willie68/w6502sbc/ideas.md

# Einige Ideen zum W6502SBC

## UART

- MAX3100 als Single UART per SPI
- Arduino Pro Micro als Single UART inkl. USB ansprechen per 6522 Bitbang SPI, oder evtl. eigenes Protokoll (Nibble Bus)

## Doppel bin2hex 7-seg 
https://www.instructables.com/Dual-BCD-to-Hex-7-Segment-Driver/
