willie68/w6502sbc/hardware/bestellen.md

# Bei Mouser

W65C02S  1x

https://www.mouser.de/ProductDetail/Western-Design-Center-WDC/W65C02S6TPG-14?qs=opBjA1TV903lvWo9AEKH5w%3D%3D

W65C22N2  2x

https://www.mouser.de/ProductDetail/Western-Design-Center-WDC/W65C22N6TPG-14?qs=opBjA1TV901DbgJ9rfcBoQ%3D%3D

CPLD ATF16V8B-15PU 5x

https://www.mouser.de/ProductDetail/?qs=2mdvTlUeTfCsdBIzx6v3gA%3D%3D

DS1813 2x

https://www.mouser.de/ProductDetail/Maxim-Integrated/DS1813-5%2bTR?qs=Jw2w9zrI6w81XtBxYQvCNA%3D%3D

DIl40 x10

DIL16 x10

DIL14 x10

DIL20 x10

DIL32 x10

# 

# Reichelt

Takt 1MHz und 8Mhz

https://www.reichelt.de/quarzoszillator-1-0-mhz-oszi-1-000000-p13673.html?&trstct=pos_1&nbc=1

https://www.reichelt.de/quarzoszillator-8-00-mhz-oszi-8-000000-p13723.html?&trstct=pos_2&nbc=1

Quarz 2x

https://www.reichelt.de/standardquarz-grundton-1-84-mhz-iqd-lfxtal003033-p245394.html?&trstct=pol_0&nbc=1

Kondensatoren 100nF 20x

https://www.reichelt.de/vielschicht-kerko-100nf-50v-125-c-c3x7r-100nb50-p206878.html?&trstct=pol_1&nbc=1

SST39SF010A 70ns, 128Kb Nor Flash

74HC138 5x

74HC688  5x

74HC00 5x

74HC85 4-Bit comparator 5x

# Ebay

R65C51 2x

Atf22V10C-15pu
