willie68/w6502sbc/images/20220719_144343.jpg

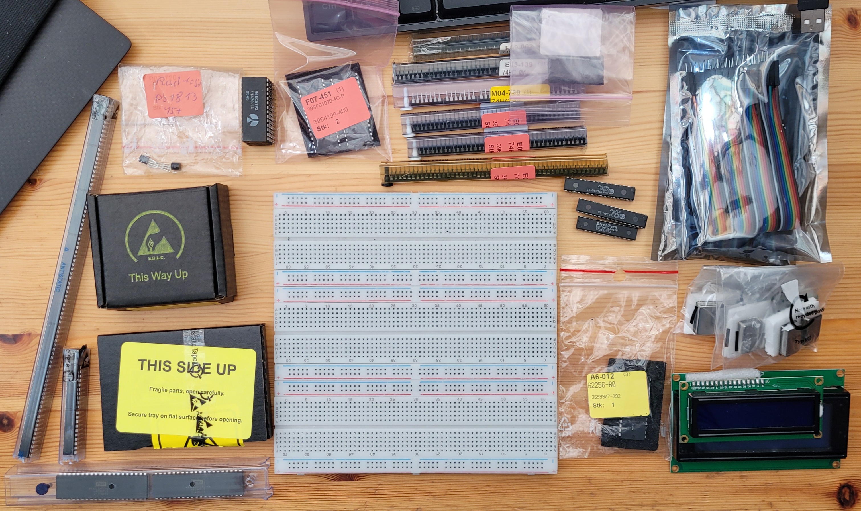
images/20220719_144343.jpg
