willie68/w6502sbc/images/NOP_Logic.jpg

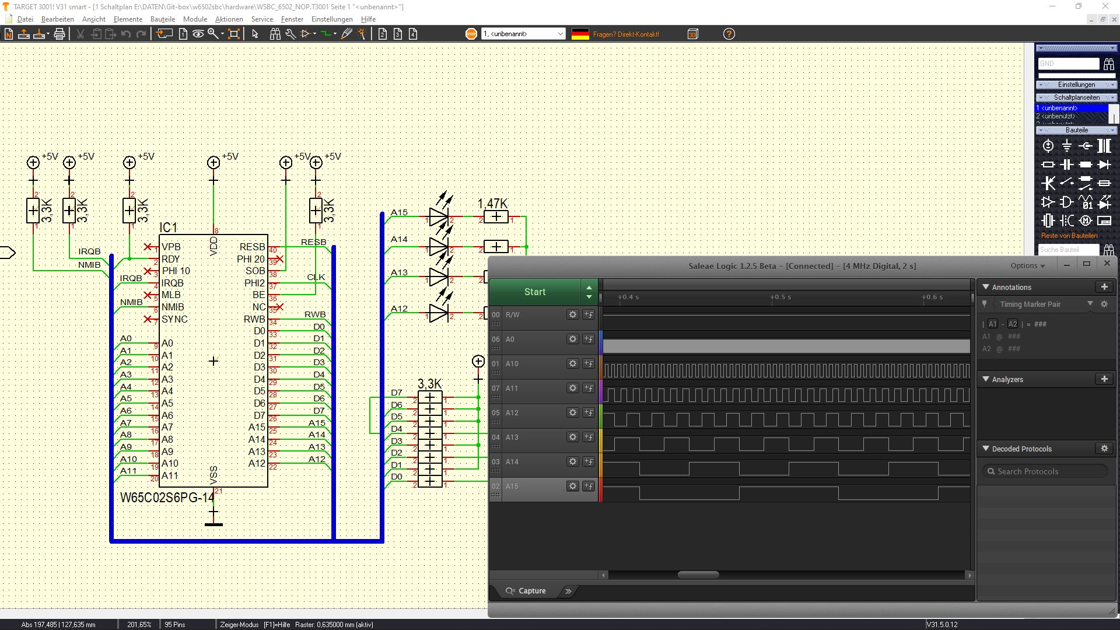
images/NOP_Logic.jpg
