willie68/w6502sbc/hardware/WSBC_6502_SBC_SCH.PDF

A1

A0

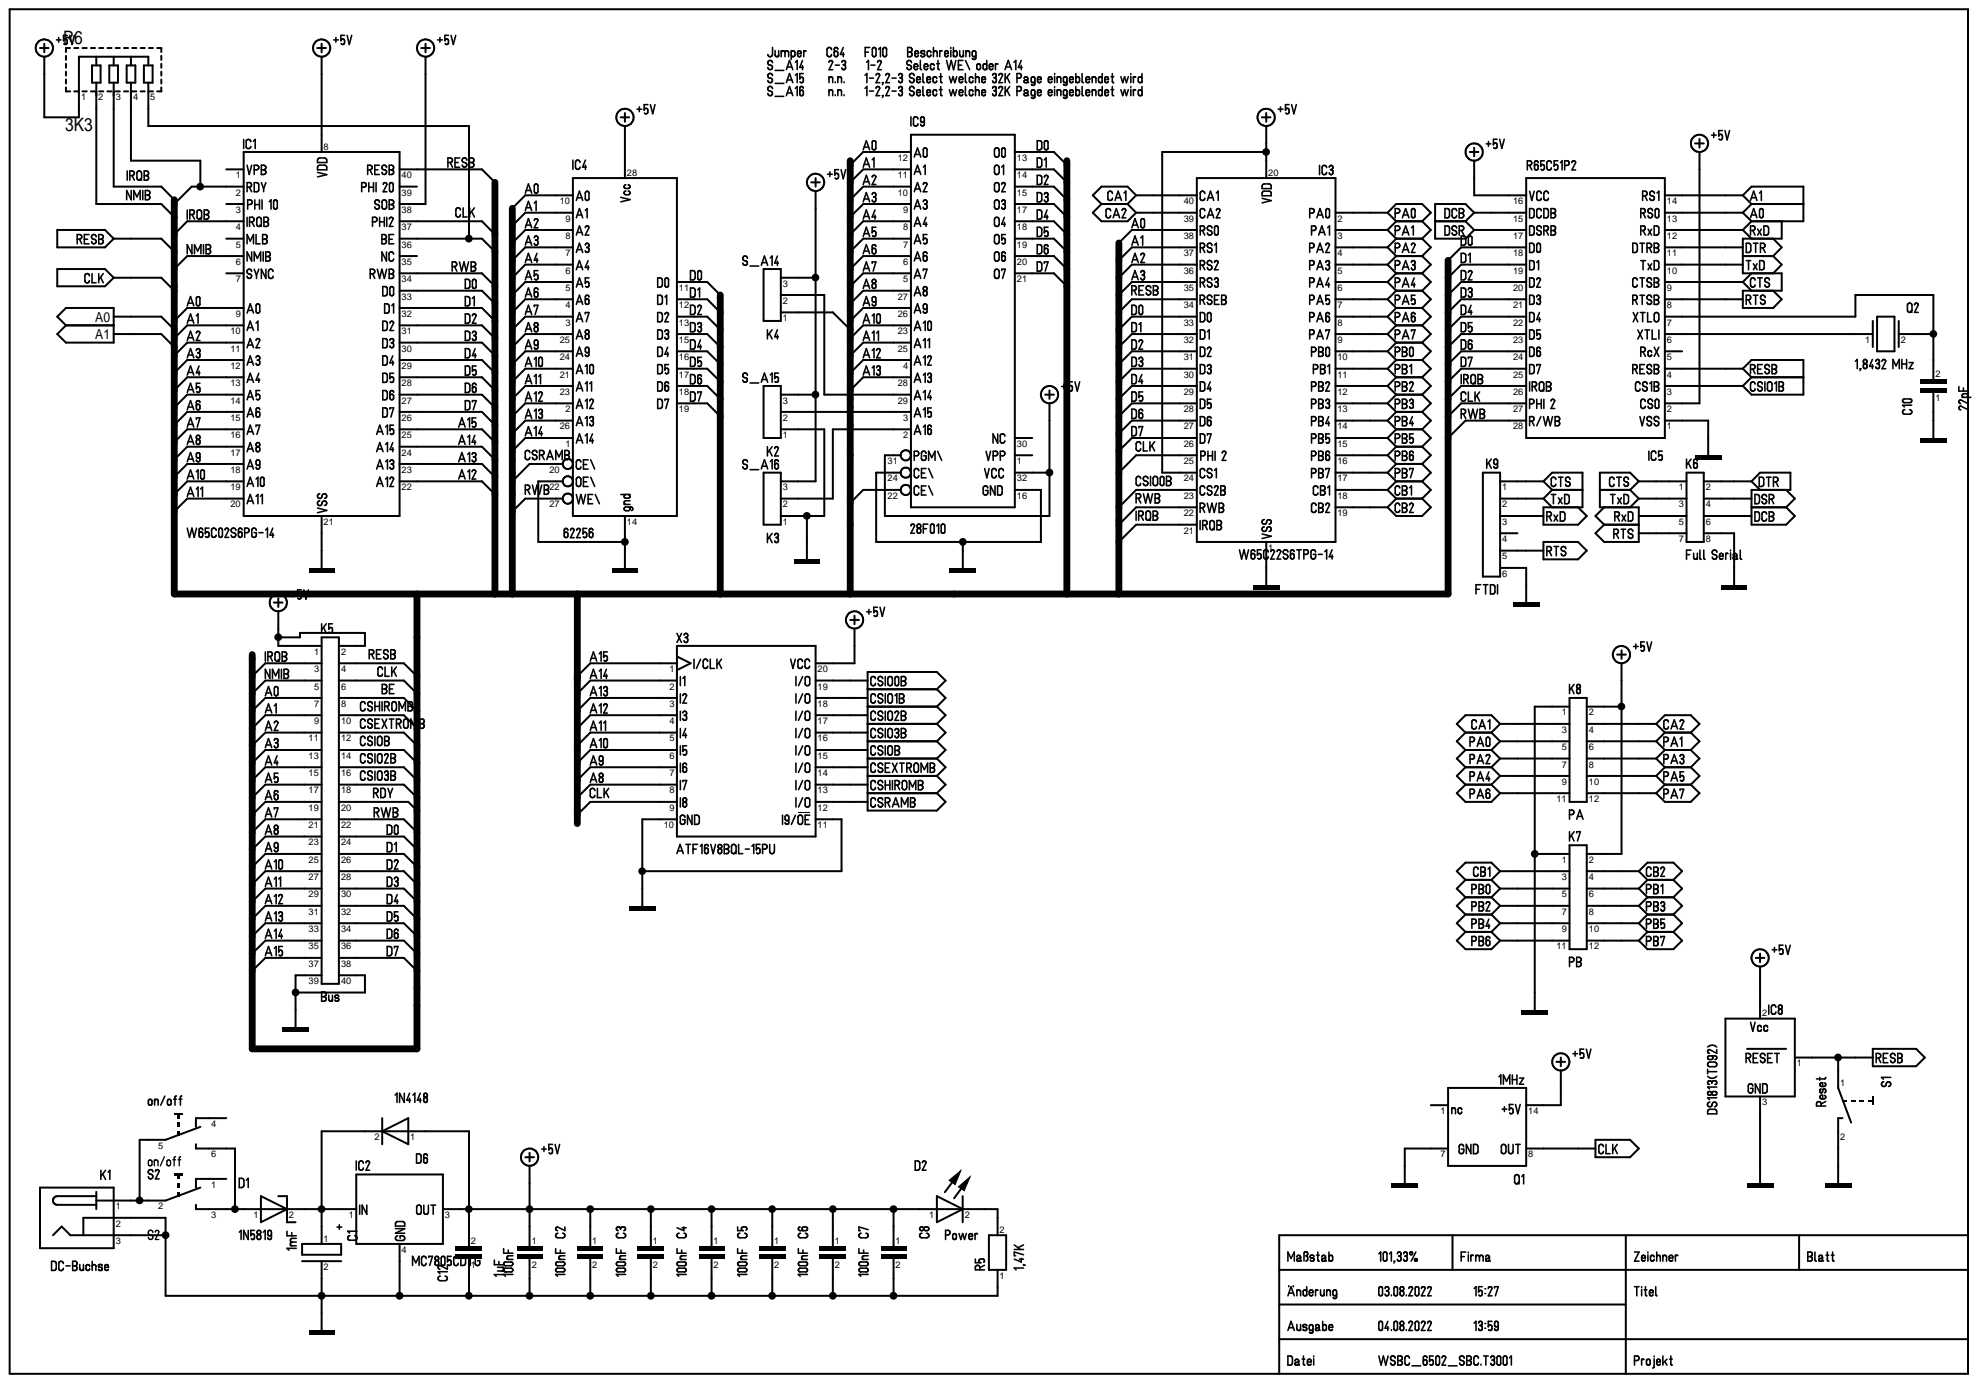
[picture p29: page 1]
