willie68/w6502sbc/hardware/WSBC_6502_ADR_LOGIC_2_SCH.PDF

IC2

IC4

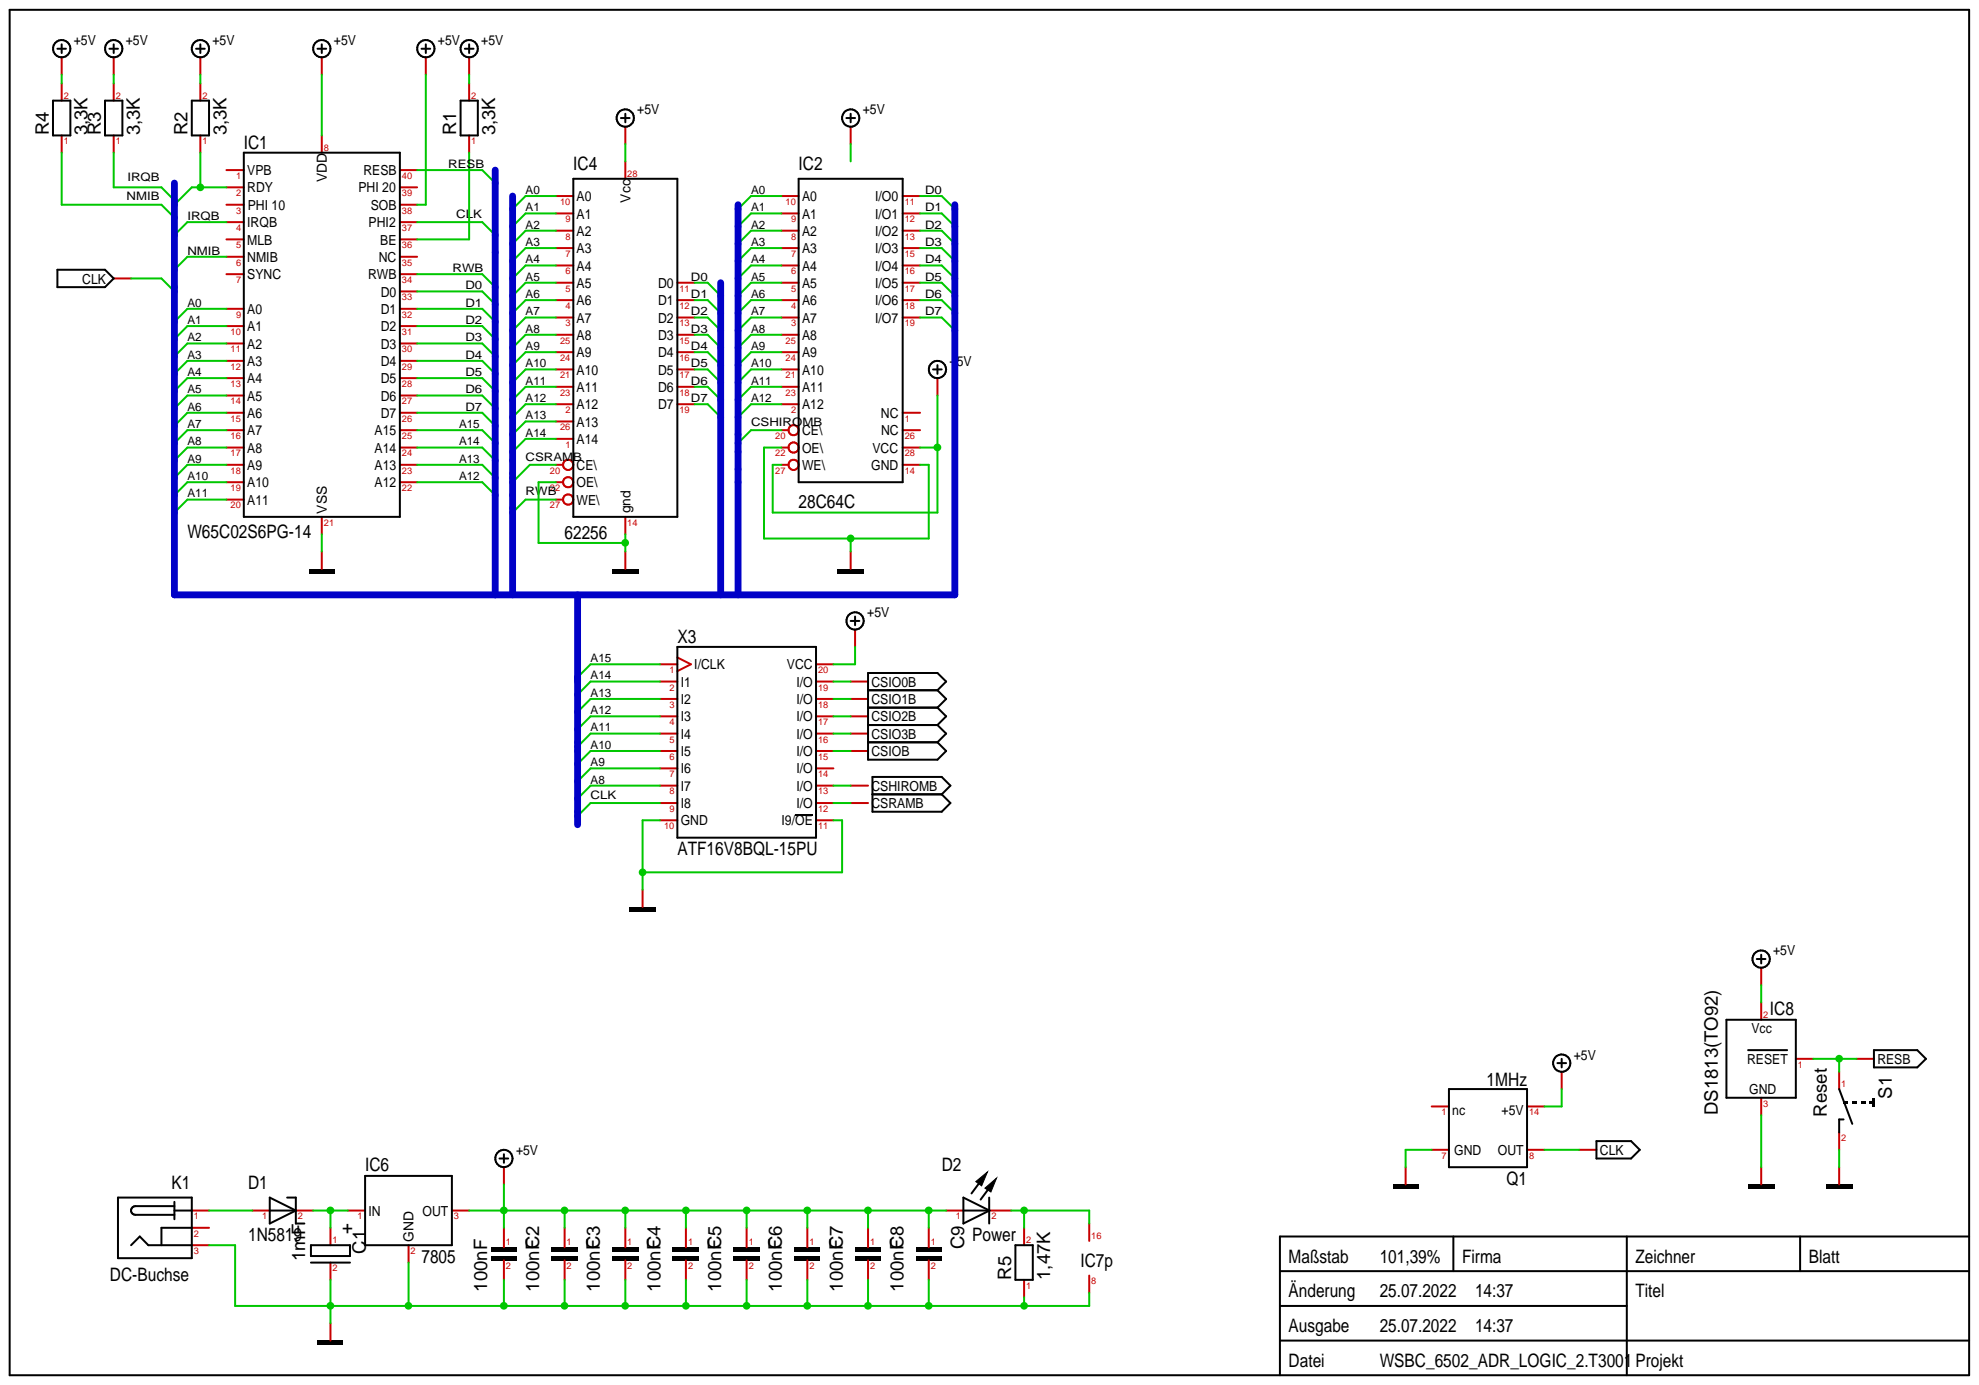
[picture p30: page 1]

Maßstab 101,39% | Firma | Zeichner | Blatt
Änderung 25.07.2022 14:37 | | Titel
