willie68/w6502sbc/hardware/WSBC_6502_ROM_RAM_SCH.PDF

IC2

IC4

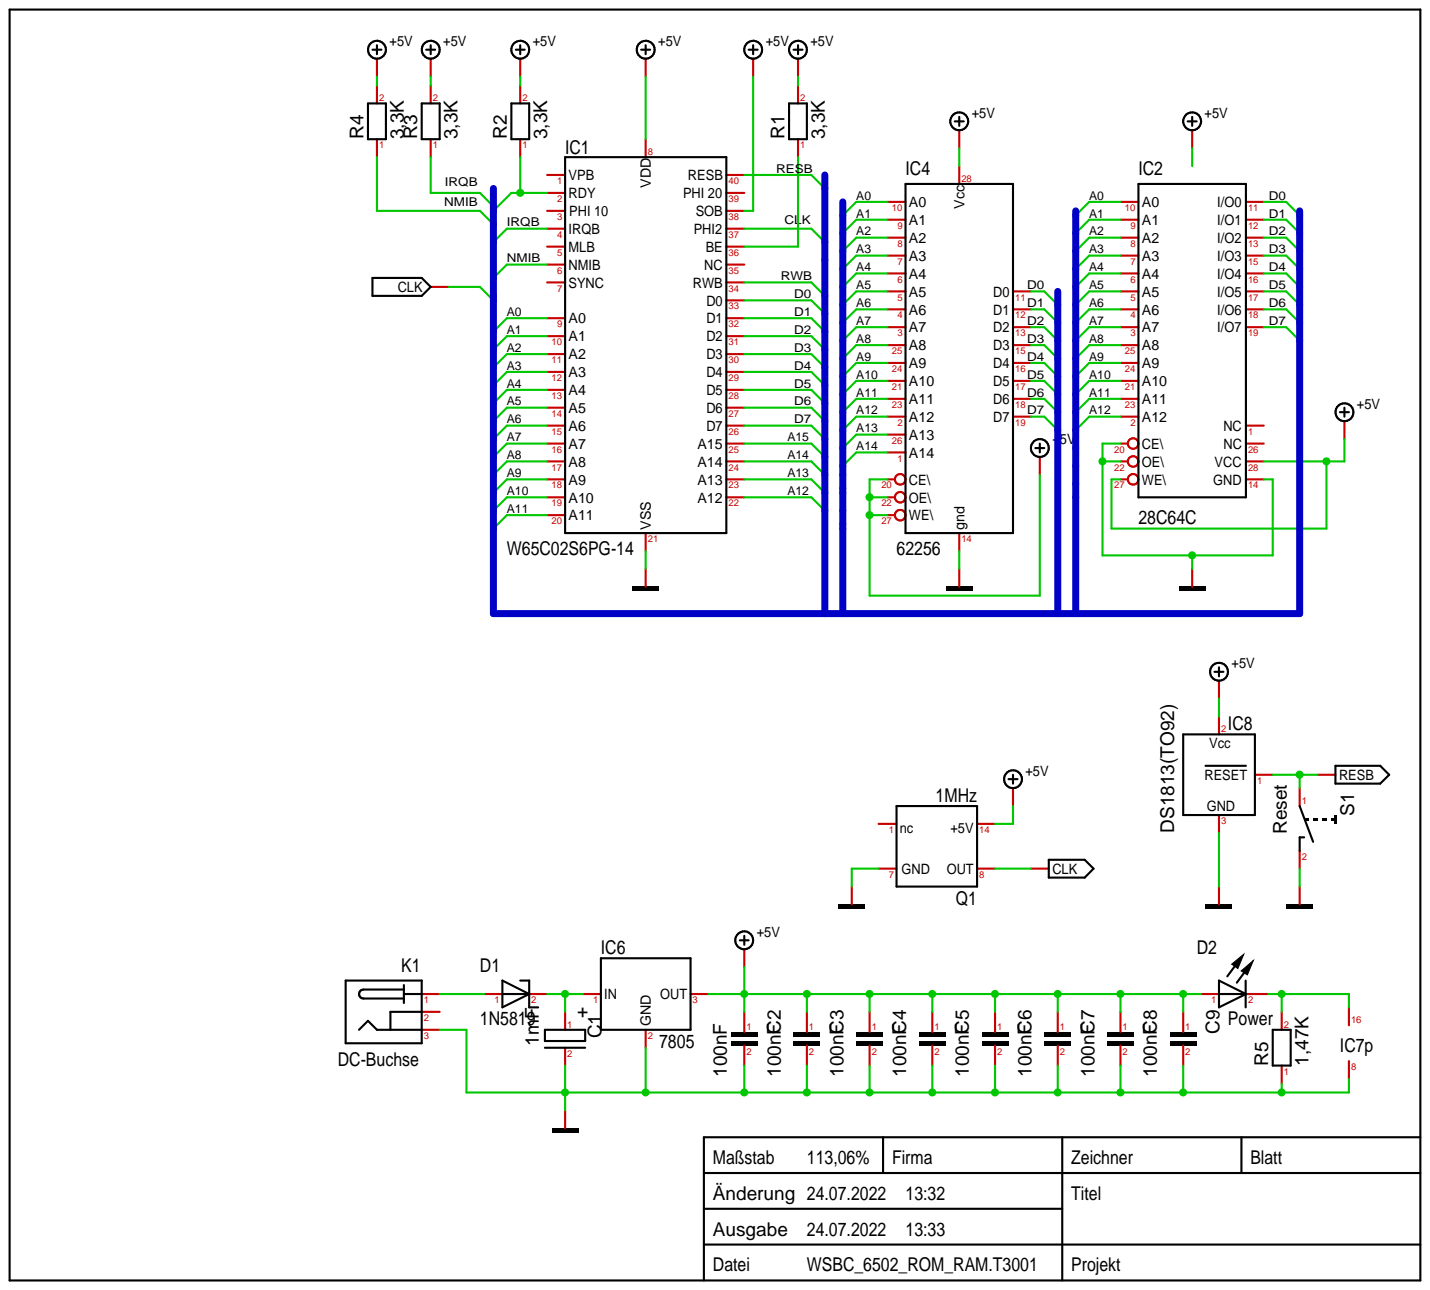
[picture p31: page 1]

Maßstab 113,06% | Firma | Zeichner | Blatt
Änderung 24.07.2022 13:32 | | Titel
