willie68/w6502sbc/hardware/WSBC_6502_NOP_SCH.PDF

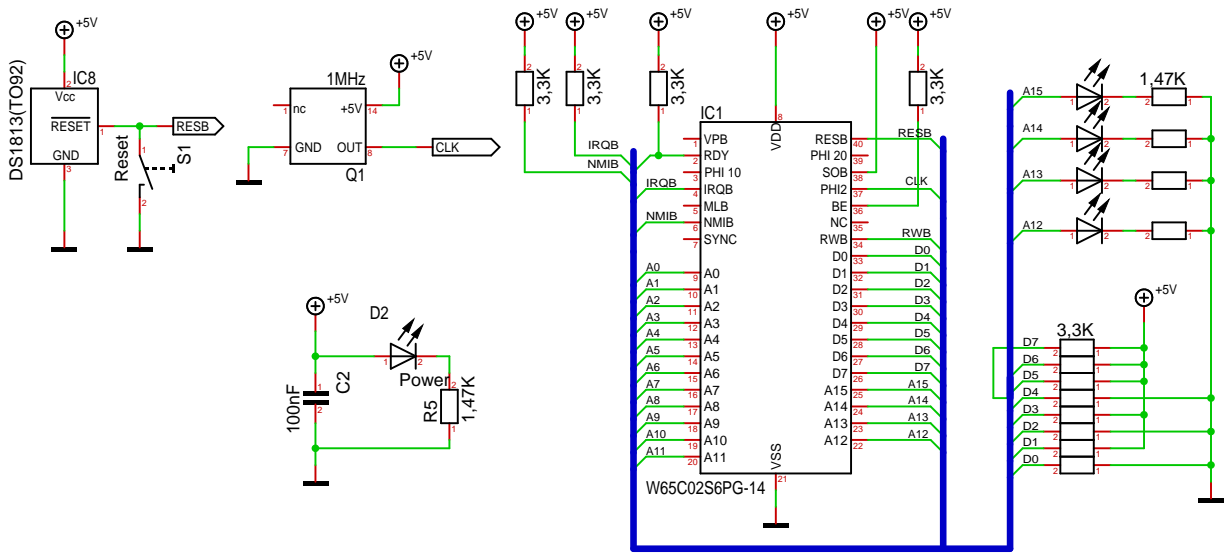
[picture p32: page 1]
