willie68/w6502sbc/software/arduino/6502-monitor/6502-monitor.ino

#include <avdweb_Switch.h>

//A0..A15
//const char ADDR[] = {22, 24, 26, 28, 30, 32, 34, 36, 38, 40, 42, 44, 46, 48, 50, 52};
//D0..D7
//const char DATA[] = {39, 41, 43, 45, 47, 49, 51, 53};

//A15..A0
const char ADDR[] = {52, 50, 48, 46, 44, 42, 40, 38, 36, 34, 32, 30, 28, 26, 24, 22};
//D7..D1
const char DATA[] = {53, 51, 49, 47, 45, 43, 41, 39};

#define CLOCK 2
#define READ_WRITE 3
#define CLK 4
#define DT 50
#define PRG 9
#define AUTO 8
#define SPD 0
Switch prgBtn = Switch(PRG); // GPIO 4

void setup() {
  for (int n = 0; n < 16; n += 1) {
    pinMode(ADDR[n], INPUT);
  }
  for (int n = 0; n < 8; n += 1) {
    pinMode(DATA[n], INPUT);
  }
  pinMode(CLOCK, INPUT);
  pinMode(READ_WRITE, INPUT);
  pinMode(CLK, OUTPUT);
  pinMode(LED_BUILTIN, OUTPUT);

  pinMode(PRG, INPUT_PULLUP);
  pinMode(AUTO, INPUT_PULLUP);

  attachInterrupt(digitalPinToInterrupt(CLOCK), onClock, RISING);

  Serial.begin(115200);
}

void onClock() {
  char output[15];

  unsigned int address = 0;
  for (int n = 0; n < 16; n += 1) {
    int bit = digitalRead(ADDR[n]) ? 1 : 0;
    Serial.print(bit);
    address = (address << 1) + bit;
  }

  Serial.print("   ");

  unsigned int data = 0;
  for (int n = 0; n < 8; n += 1) {
    int bit = digitalRead(DATA[n]) ? 1 : 0;
    Serial.print(bit);
    data = (data << 1) + bit;
  }

  sprintf(output, "   %04x  %c %02x", address, digitalRead(READ_WRITE) ? 'r' : 'W', data);
  Serial.println(output);
}
bool pulse;
word speed;
bool autoclk;

void loop() {
  autoclk = digitalRead(AUTO);
  if (!autoclk) {
    prgBtn.poll();
  }

  if (autoclk || prgBtn.switched()) {
    digitalWrite(CLK, pulse);
    digitalWrite(LED_BUILTIN, pulse);
    speed = map(analogRead(SPD), 0, 1024, 0, 200);
    delay(speed);
    pulse = !pulse;
  }
}
