willie68/w6502sbc/software/bios/messages.asm

	message_w6502sbc: .asciiz "W6502SBC"
	message_welcome: .asciiz "Welcome"
	message_ramtas: .asciiz "RAMTAS"
	message_srvinit: .asciiz "SRV INIT"
	message_ready: .asciiz "ready"
	message_showdec: .asciiz "show dec"
	message_britta: .asciiz "Hallo Britta"
	message_memory: .asciiz "free mem: "
	message_menu: .asciiz "1: Mon 2: Basic"
	message_monitor: .asciiz "extended monitor"
	message_basic: .asciiz "Basic"
	message_unknown: .asciiz "unknown"
