willie68/w6502sbc/(commit log)

2022-07-20 WIP: addressdecoding
    [adr_logic.ods]
2022-07-21 adding the bus to the schematics
2022-07-21 try to add a NOLORAM switch to the address decoder.
2022-07-21 WIP: adding NoLoROM signal to adress decoder
    [adr_logic.ods]
2022-07-22 WIP: starting first cross assemblies
    [w6502sbc.cfg]
2022-07-25 WIP switching to wpld, adding simple address logic to blog
2022-07-28 WIP: first PCB Layout...
2022-08-02 WIP: new version of board
2022-08-02 WIP: create PDF for schematic
2022-08-10 WIP: new CPLD, hopfully without any errors
    [bios.asm]
2022-08-16 WIP: adding kiffy timer, isr routines, ram test to kernel
2022-08-17 WIP: some changes, relocating reset button
2022-08-19 WIP: little changes
    adding jiffy clock generator schematics
2022-08-20 WIP: first PCB Version running
2022-08-21 WIP: order ZIF PCB
2022-08-22 WIP: include right io definition
    [w6502sbc.cfg]
2022-08-25 WIP: test with cc65 asm
    [w6502sbc.cfg]
2022-08-25 WIP: changes in config file
    [w6502sbc.cfg]
2022-08-26 WIÜ: testing CA65 assembler...
    [w6502sbc.cfg]
2022-08-28 WIP: switching to 4-bit LCD interface.
2022-08-30 Bug: timer not starting
    [bios.asm]
2022-08-30 Bug: lcd_goto doesn't work
    [bios.asm, lcd.asm]
2022-09-06 WIP: prepare for MAX3100 SPI Seriell adapter
2022-09-08 WIP: new serial connection via SPI and MAX3100
2022-09-15 WIP: switching to function table for command execution
2022-09-26 WIP: Bug in Retro Assembler
2022-10-17 adding delay because of the WDC 6551 Bug
    [ewoz.asm]
2022-11-02 testing ser in
    - PCB: another hardware bug, DCDB <-> VCC on 6551
    - making the ser_in work
    - adding main menu to bios
    - adding ewozmon
    [bios.asm, ewoz.asm, lcd.asm, messages.asm, seriell.asm, zp.asm]
